joelpmichael/saml-jackson/jackson.kicad_pcb

## KiCad design jackson.kicad_pcb (2023-06-22)

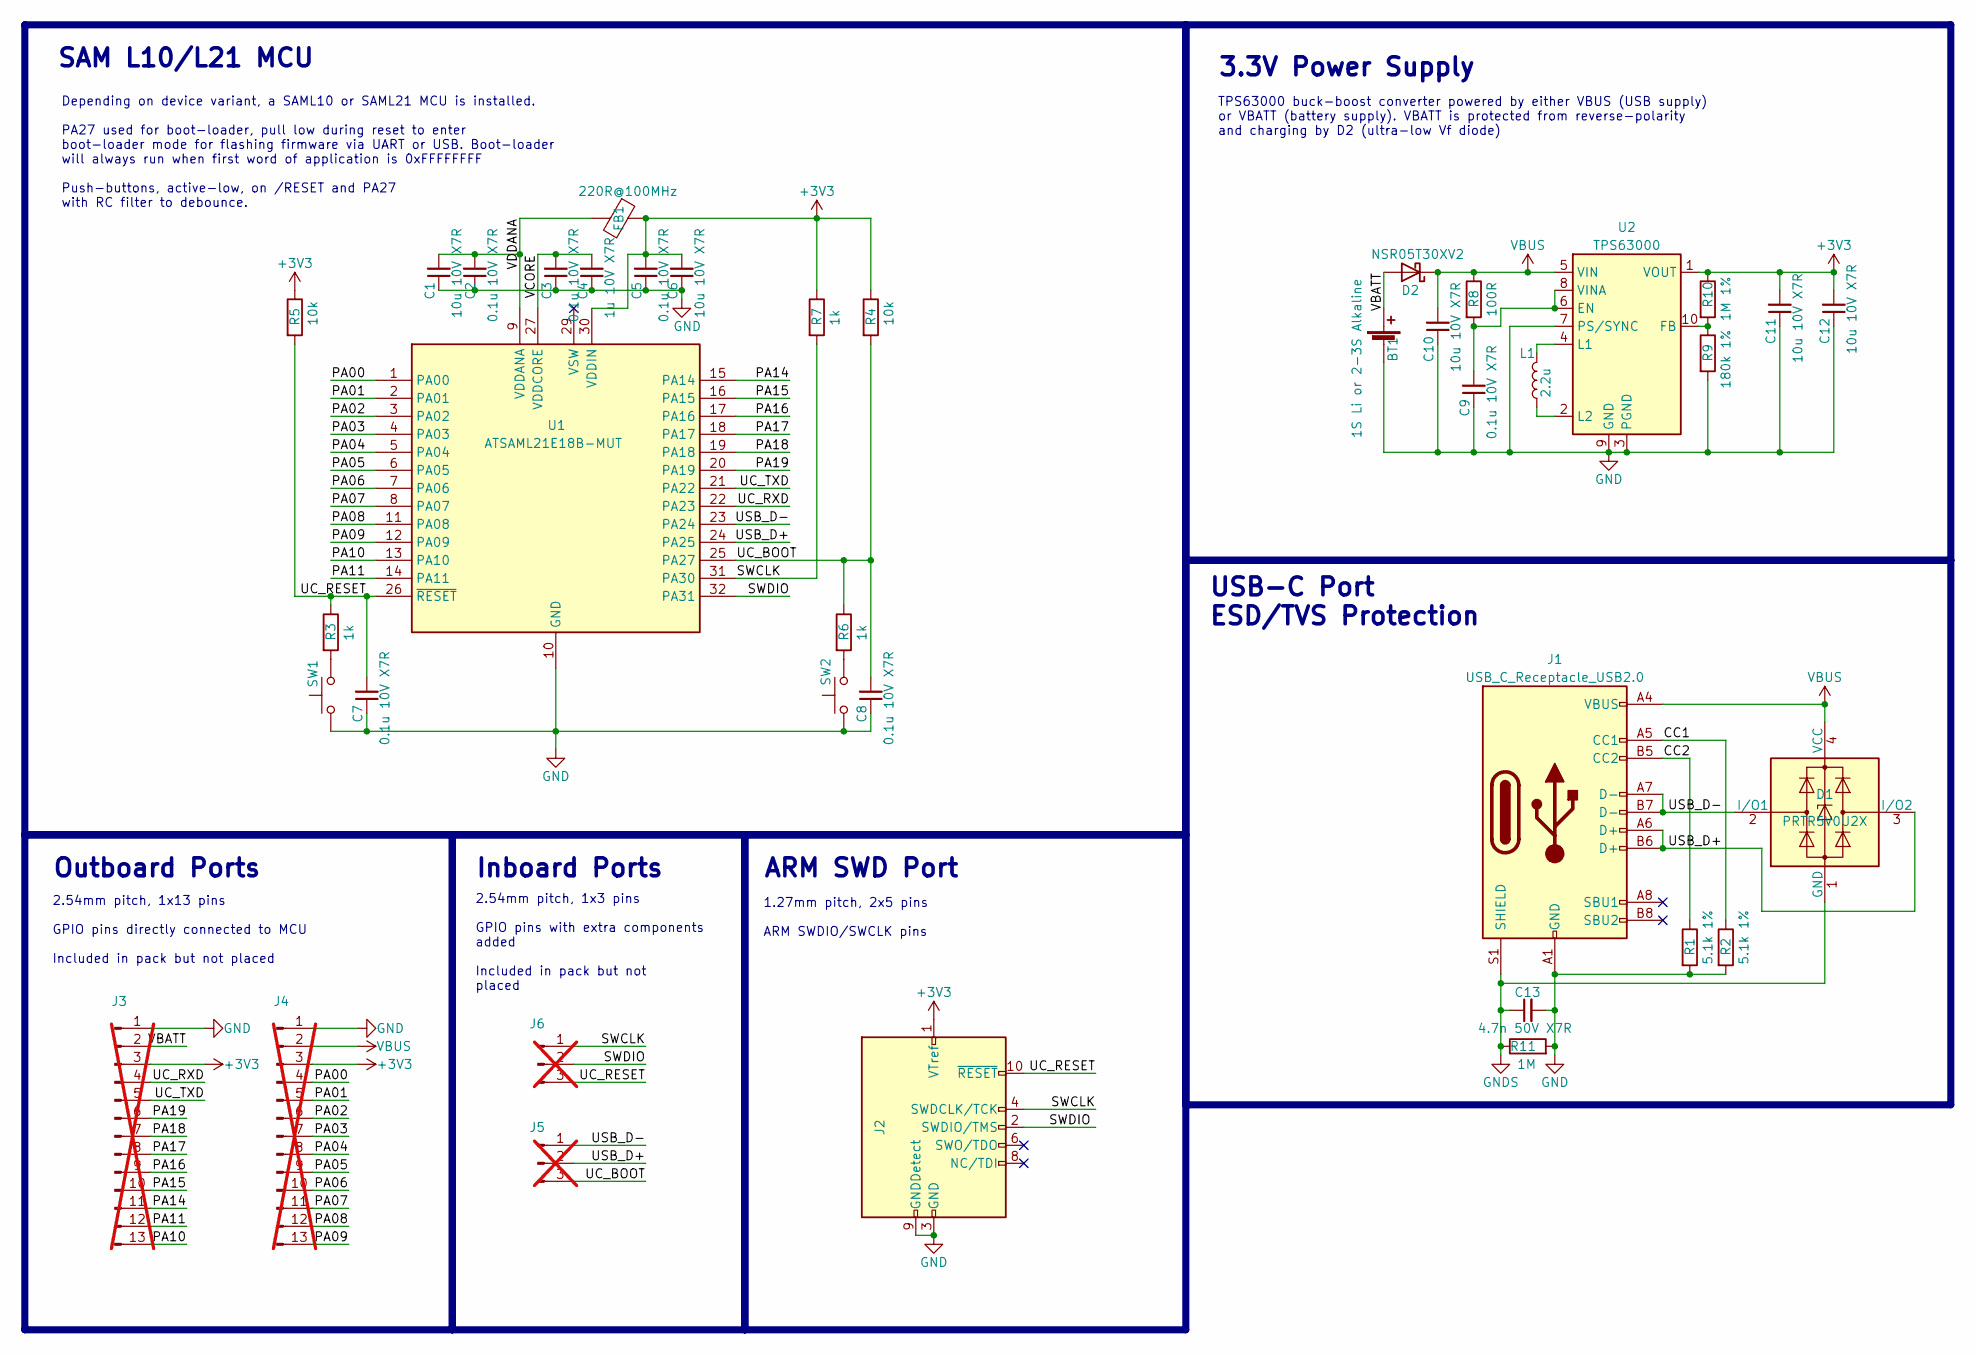
[picture p1: schematic jackson.kicad_sch, SAM-L Jackson]

Parts:
BT1: 1S Li or 2-3S Alkaline
C1, C6, C10, C11, C12: 10u 10V X7R; C_0603_1608Metric
C2, C3, C5, C7, C8, C9: 0.1u 10V X7R; C_0402_1005Metric
C4: 1u 10V X7R; C_0402_1005Metric
C13: 4.7n 50V X7R; C_0402_1005Metric
D1: PRTR5V0U2X; SOT-143
D2: NSR05T30XV2; D_SOD-523
FB1: 220R@100MHz; L_0603_1608Metric
J1: USB_C_Receptacle_USB2.0; USB_C_Receptacle_G-Switch_GT-USB-7010ASV
J2: Conn_ARM_JTAG_SWD_10; PinHeader_2x05_P1.27mm_Vertical_SMD
J3, J4: Conn_01x13_Pin; PinHeader_1x13_P2.54mm_Vertical; not fitted
J5, J6: Conn_01x03_Pin; PinHeader_1x03_P2.54mm_Vertical; not fitted
L1: 2.2u; L_1008_2520Metric
R1, R2: 5.1k 1%; R_0402_1005Metric
R3, R6, R7: 1k; R_0402_1005Metric
R4, R5: 10k; R_0402_1005Metric
R8: 100R; R_0402_1005Metric
R9: 180k 1%; R_0402_1005Metric
R10: 1M 1%; R_0402_1005Metric
R11: 1M; R_0402_1005Metric
SW1: RESET; SW_Push_SPST_NO_Alps_SKRK
SW2: BOOT; SW_Push_SPST_NO_Alps_SKRK
U1: ATSAML21E18B-MUT; QFN-32-1EP_5x5mm_P0.5mm_EP3.45x3.45mm
U2: TPS63000; Texas_DRC0010J_ThermalVias

Connections:
+3V3: C5.2, C6.2, C11.2, C12.2, FB1.1, J2.1 (VTref), J3.3, J4.3, R4.1, R5.1, R7.1, R10.1, U1.30 (VDDIN), U2.1 (VOUT)
/CC1: J1.A5 (CC1), R2.1
/CC2: J1.B5 (CC2), R1.1
/PA00: J4.4, U1.1 (PA00)
/PA01: J4.5, U1.2 (PA01)
/PA02: J4.6, U1.3 (PA02)
/PA03: J4.7, U1.4 (PA03)
/PA04: J4.8, U1.5 (PA04)
/PA05: J4.9, U1.6 (PA05)
/PA06: J4.10, U1.7 (PA06)
/PA07: J4.11, U1.8 (PA07)
/PA08: J4.12, U1.11 (PA08)
/PA09: J4.13, U1.12 (PA09)
/PA10: J3.13, U1.13 (PA10)
/PA11: J3.12, U1.14 (PA11)
/PA14: J3.11, U1.15 (PA14)
/PA15: J3.10, U1.16 (PA15)
/PA16: J3.9, U1.17 (PA16)
/PA17: J3.8, U1.18 (PA17)
/PA18: J3.7, U1.19 (PA18)
/PA19: J3.6, U1.20 (PA19)
/SWCLK: J2.4 (SWDCLK/TCK), J6.1, R7.2, U1.31 (PA30)
/SWDIO: J2.2 (SWDIO/TMS), J6.2, U1.32 (PA31)
/UC_BOOT: C8.2, J5.3, R4.2, R6.1, U1.25 (PA27)
/UC_RESET: C7.2, J2.10 (~RESET), J6.3, R3.1, R5.2, U1.26 (~RESET)
/UC_RXD: J3.4, U1.22 (PA23)
/UC_TXD: J3.5, U1.21 (PA22)
/USB_D+: D1.3 (I/O2), J1.A6 (D+), J1.B6 (D+), J5.2, U1.24 (PA25)
/USB_D-: D1.2 (I/O1), J1.A7 (D-), J1.B7 (D-), J5.1, U1.23 (PA24)
/VBATT: BT1.1 (+), D2.2 (A), J3.2
/VCORE: C3.2, C4.2, U1.27 (VDDCORE)
/VDDANA: C1.2, C2.2, FB1.2, U1.9 (VDDANA)
GND: BT1.2 (-), C1.1, C2.1, C3.1, C4.1, C5.1, C6.1, C7.1, C8.1, C9.1, C10.1, C11.1, C12.1, C13.2, J1.A1 (GND), J1.A12 (GND), J1.B1 (GND), J1.B12 (GND), J2.3 (GND), J2.5 (GND), J2.9 (GNDDetect), J3.1, J4.1, R1.2, R2.2, R9.2, R11.2, SW1.1, SW2.2, U1.10 (GND), U1.28 (GND), U2.3 (PGND), U2.7 (PS/SYNC), U2.9 (GND), U2.11 (PGND)
GNDS: C13.1, D1.1 (GND), J1.S1 (SHIELD), R11.1
unnamed: R3.2, SW1.2
unnamed: R6.2, SW2.1
unnamed: C9.2, R8.2, U2.6 (EN), U2.8 (VINA)
unnamed: R9.1, R10.2, U2.10 (FB)
unnamed: L1.2, U2.4 (L1)
unnamed: L1.1, U2.2 (L2)
VBUS: C10.2, D1.4 (VCC), D2.1 (K), J1.A4 (VBUS), J1.A9 (VBUS), J1.B4 (VBUS), J1.B9 (VBUS), J4.2, R8.1, U2.5 (VIN)

Notes on the sheet:
USB-C Port ESD/TVS Protection
1.27mm pitch, 2x5 pins ARM SWDIO/SWCLK pins
SAM L10/L21 MCU
TPS63000 buck-boost converter powered by either VBUS (USB supply) or VBATT (battery supply). VBATT is protected from reverse-polarity and charging by D2 (ultra-low Vf diode)
Outboard Ports
2.54mm pitch, 1x13 pins GPIO pins directly connected to MCU Included in pack but not placed
ARM SWD Port
3.3V Power Supply
2.54mm pitch, 1x3 pins GPIO pins with extra components added Included in pack but not placed
Depending on device variant, a SAML10 or SAML21 MCU is installed. PA27 used for boot-loader, pull low during reset to enter boot-loader mode for flashing firmware via UART or USB. Boot-loader will always run when first word of application is 0xFFFFFFFF Push-buttons, active-low, on /RESET and PA27 w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
Inboard Ports

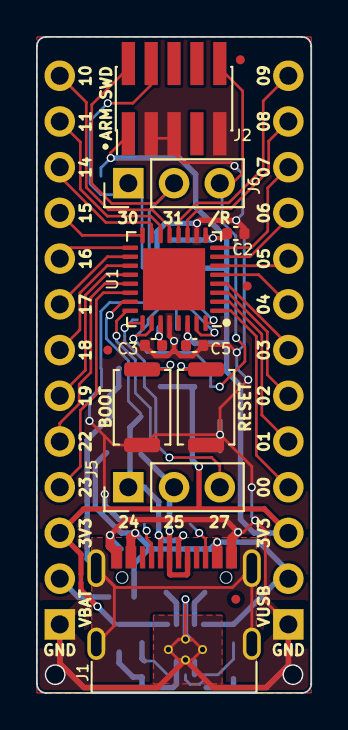
[picture p2: board jackson.kicad_pcb from above]

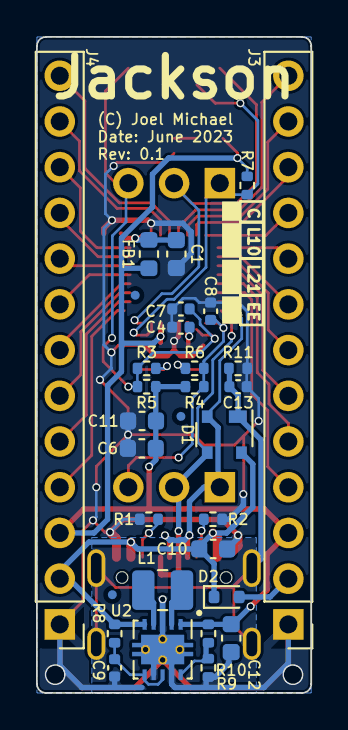
[picture p3: board jackson.kicad_pcb from below]

Board: 2 copper layers, 15.2 x 36.4 mm, 38 parts (28 on the bottom side), 41 nets.
