joelpmichael/saml-jackson/(commit log)

2023-06-20 update schematic, add pinout diagram for L10 variant
2023-06-22 Update schematic to use background colour instead of transparent
2023-06-22 Create UUID for the project, used to generate UUIDs for completed boards
2023-06-22 add KiCad schematic and layout
    [jackson.kicad_pcb, jackson.kicad_sch]
